melROLL/Opti.Prod/Documentation/Spec and POC !/poc_3.JPG

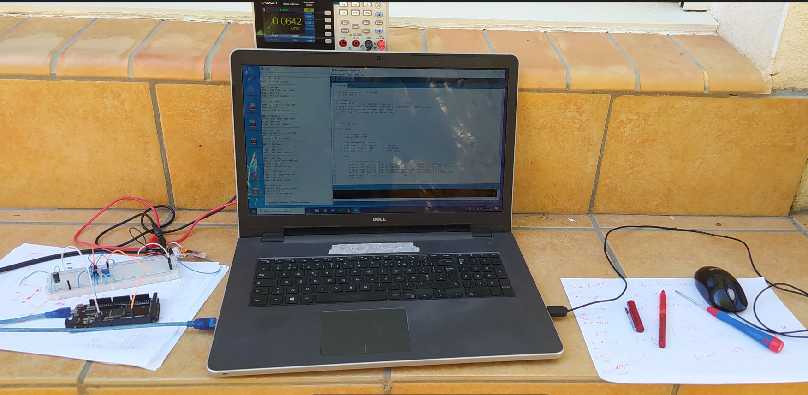
Documentation/Spec and POC !/poc_3.JPG
