melROLL/Opti.Prod/Documentation/Spec and POC !/poc_2.JPG

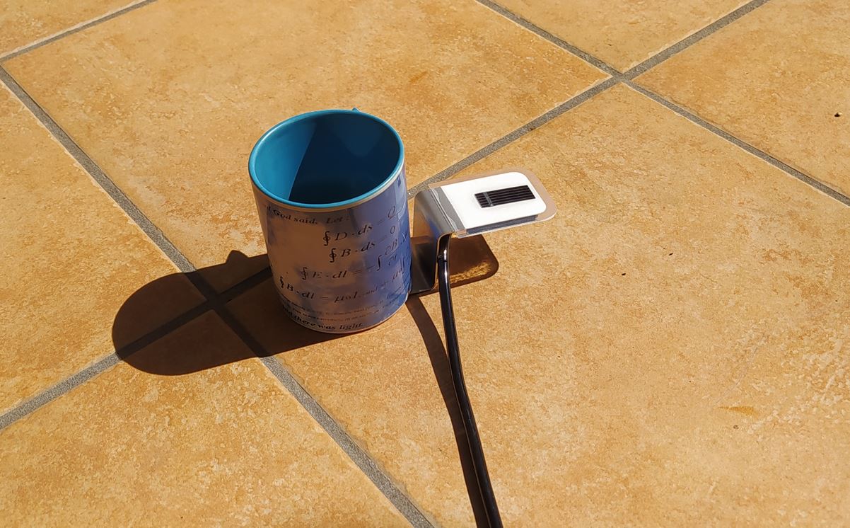
Documentation/Spec and POC !/poc_2.JPG
