melROLL/Opti.Prod/Documentation/Spec and POC !/poc_1.JPG

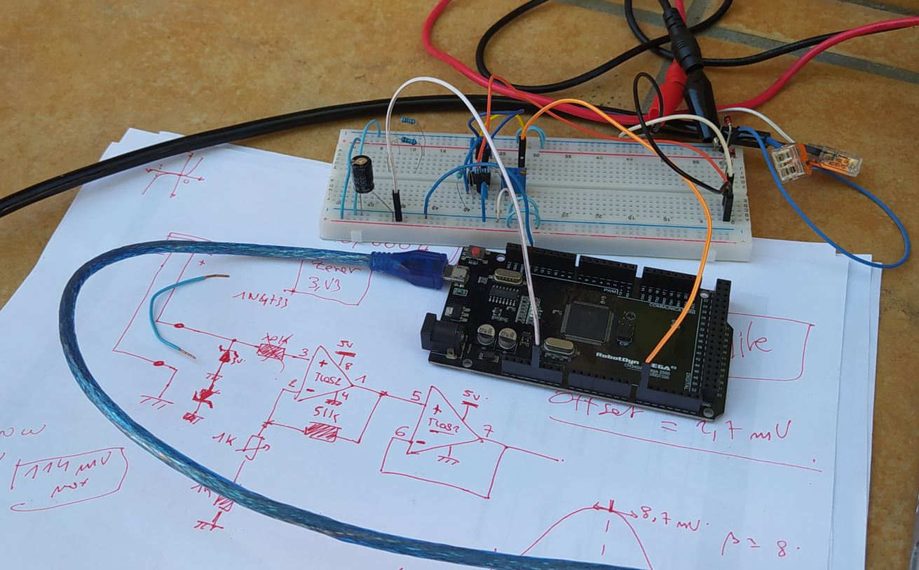
Documentation/Spec and POC !/poc_1.JPG
