melROLL/Opti.Prod/Documentation/Spec and POC !/poc_4.JPG

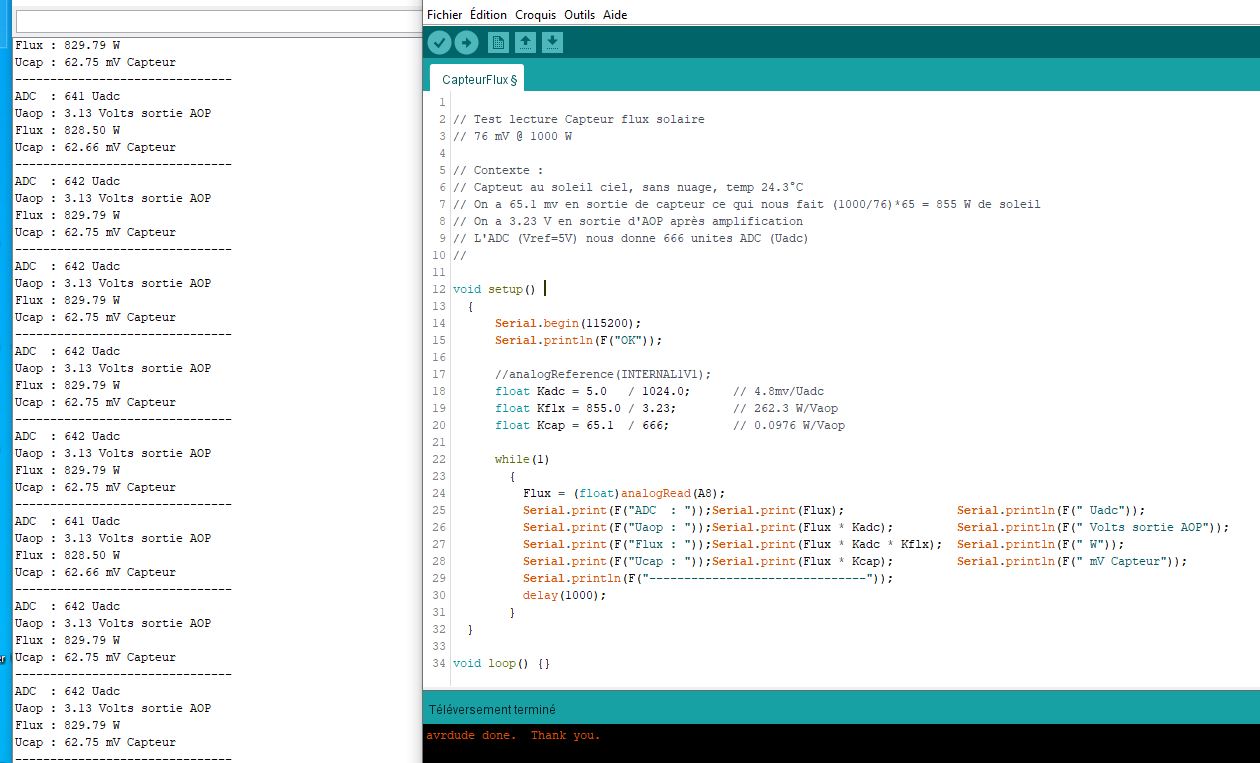
Documentation/Spec and POC !/poc_4.JPG
