melROLL/Opti.Prod/Media/PFP next.jpg

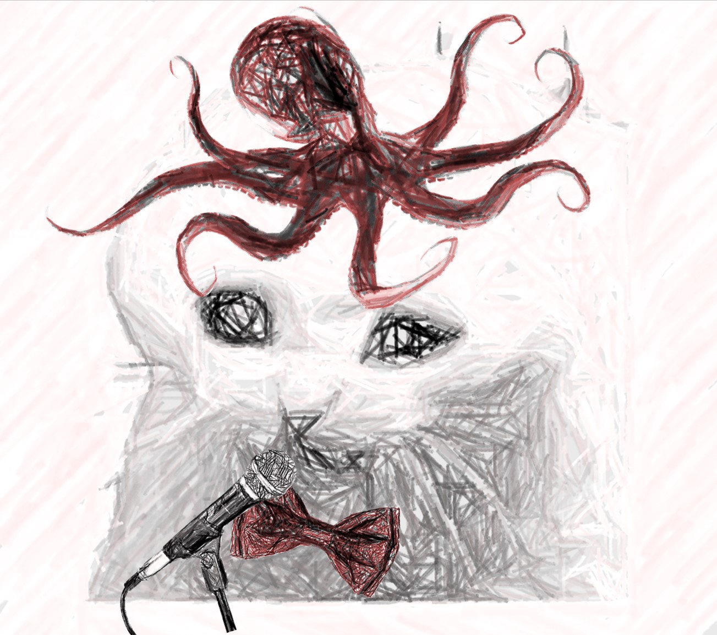
Media/PFP next.jpg
