melROLL/Opti.Prod/Clean_Realease/3DPrintingFile/BoxTop.stl

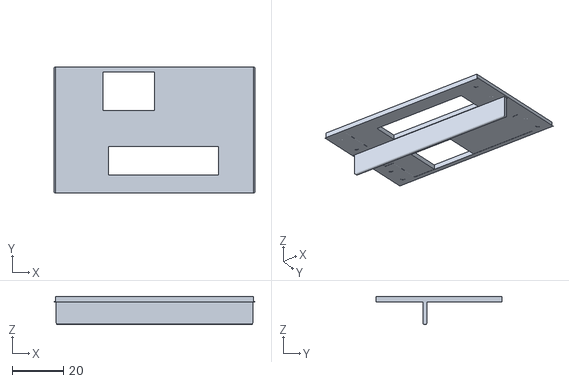
[picture p10: CAD file, 2024-01-13]
Clean_Realease/3DPrintingFile/BoxTop.stl
78.2 x 49.0 x 11.0
