melROLL/Opti.Prod/Clean_Realease/3DPrintingFile/DinRailMount13mm.stl

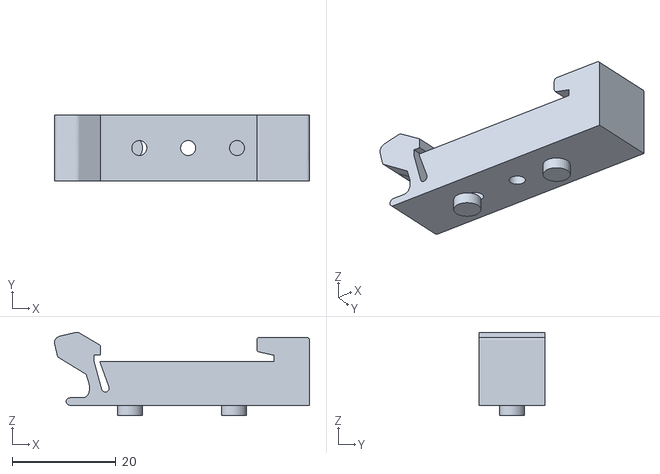
[picture p11: CAD file, 2024-01-12]
Clean_Realease/3DPrintingFile/DinRailMount13mm.stl
49.1 x 12.7 x 16.1
