melROLL/Opti.Prod/Hardware/CadDesign/MountForBox.stl

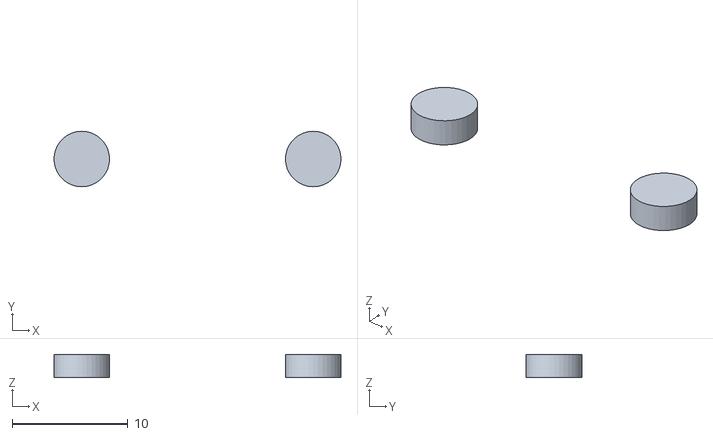
[picture p12: CAD file, 2024-01-12]
Hardware/CadDesign/MountForBox.stl
24.8 x 4.80 x 2.00
