melROLL/Opti.Prod/Hardware/CadDesign/din_rail_mount_G9.STL

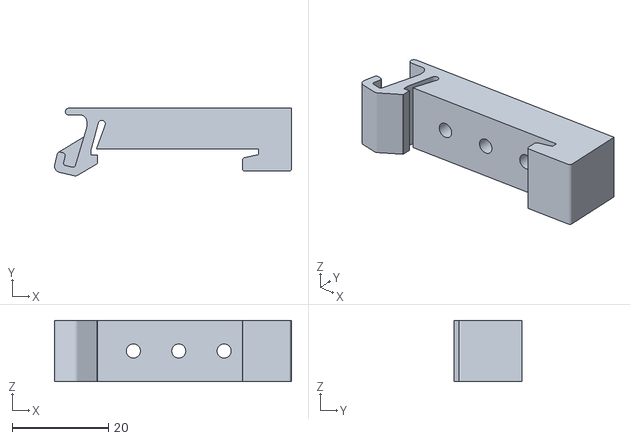
[picture p13: CAD file, 2024-01-12]
Hardware/CadDesign/din_rail_mount_G9.STL
49.1 x 14.1 x 12.7
