melROLL/Opti.Prod/Clean_Realease/3DPrintingFile/DinRailMount30mm.stl

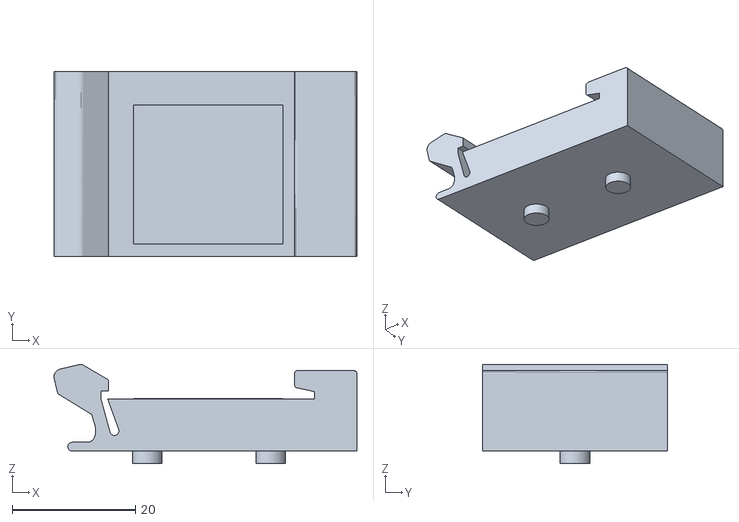
[picture p14: CAD file, 2024-01-12]
Clean_Realease/3DPrintingFile/DinRailMount30mm.stl
49.1 x 30.0 x 16.1
