melROLL/Opti.Prod/Clean_Realease/3DPrintingFile/Box.stl

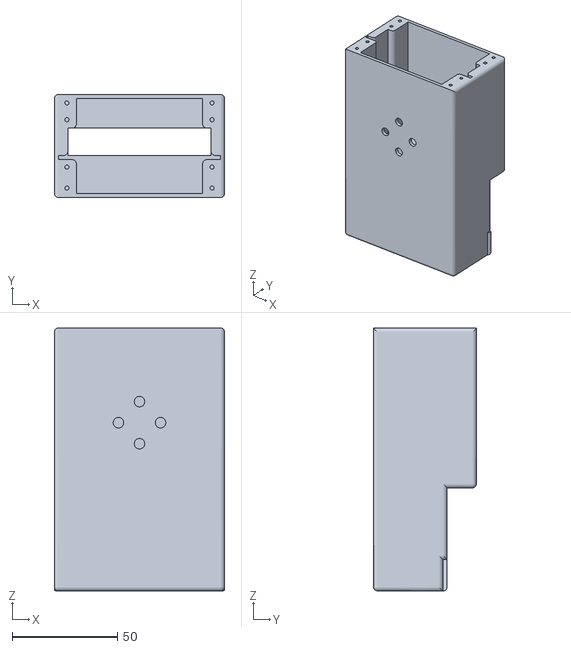
[picture p15: CAD file, 2024-01-11]
Clean_Realease/3DPrintingFile/Box.stl
81.0 x 49.0 x 125.0
