melROLL/Opti.Prod/Hardware/CadDesign/boxmoneymoney.stl

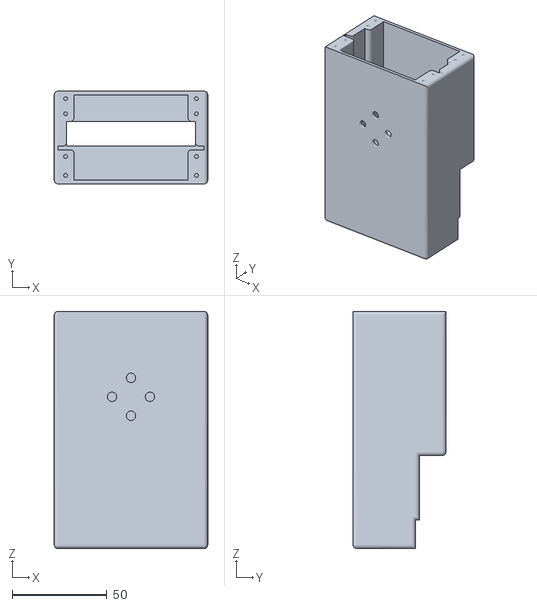
[picture p16: CAD file, 2024-01-10]
Hardware/CadDesign/boxmoneymoney.stl
81.0 x 49.0 x 125.0
