melROLL/Opti.Prod/Hardware/CadDesign/boxmoneymoneyTop.stl

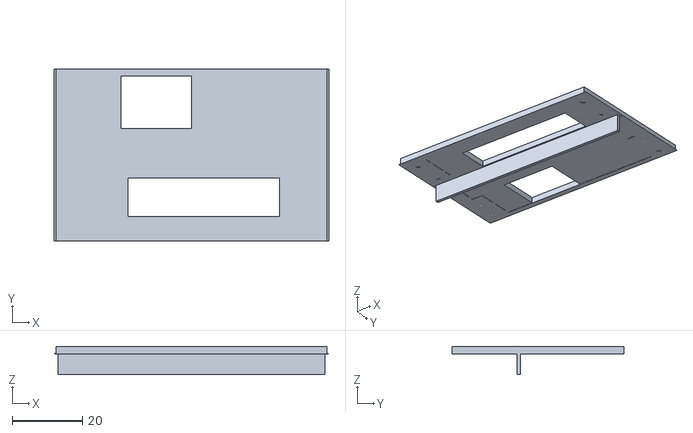
[picture p17: CAD file, 2024-01-11, an earlier design]
Hardware/CadDesign/boxmoneymoneyTop.stl
78.2 x 49.0 x 8.00
