melROLL/Opti.Prod/(list of files, cad)

Other CAD files:
Hardware/CadDesign/DinRail.CATPart
Hardware/CadDesign/boxmoneymoney V2.CATPart
Hardware/CadDesign/boxmoneymoney.CATPart
Hardware/CadDesign/boxmoneymoneyTop.CATPart
