melROLL/Opti.Prod/Documentation/Spec and POC !/WDPV_ Schematic_V2.pdf

@

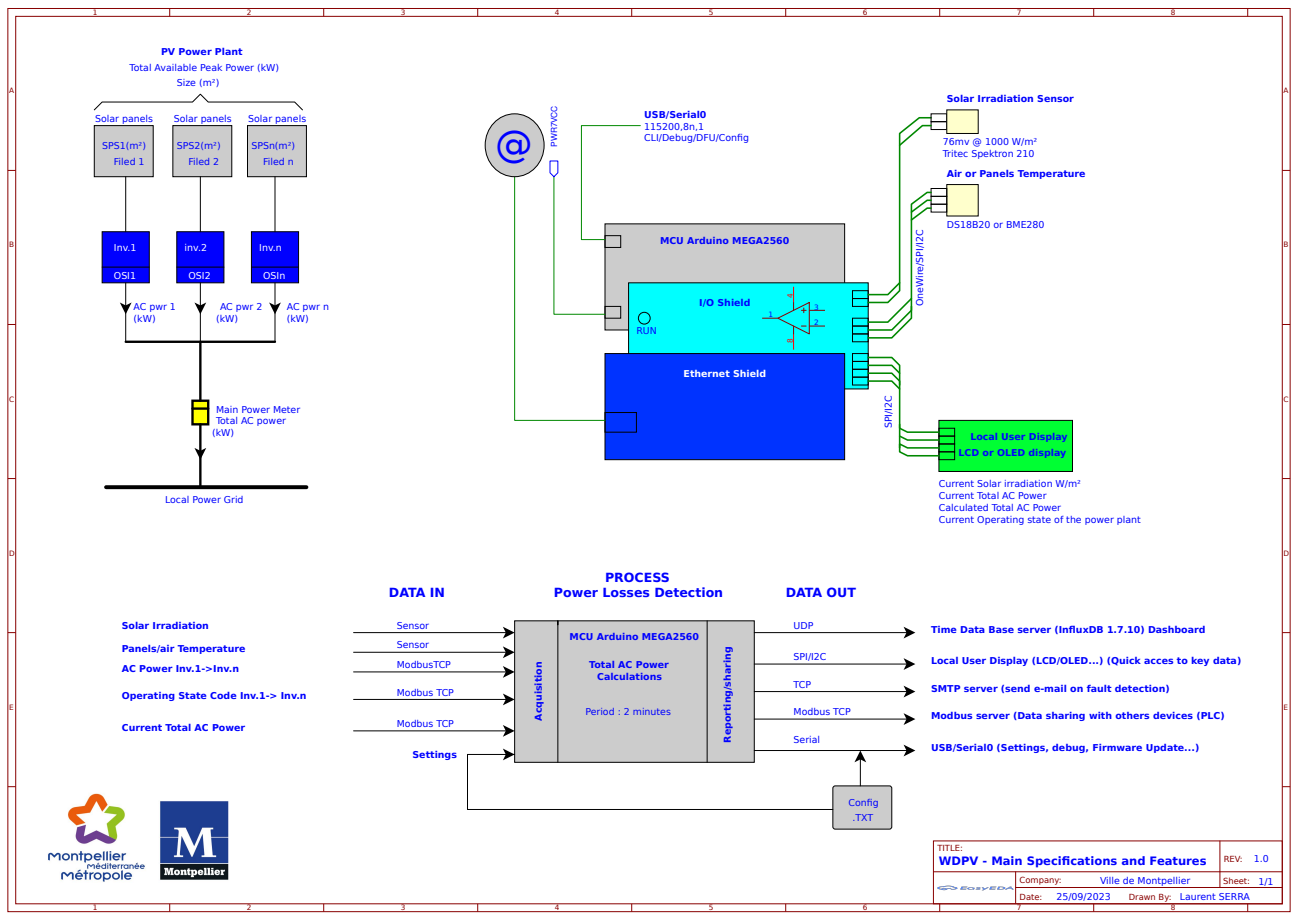
[picture p18: page 1]
TITLE:; WDPV - Main Specifications and Features; REV: 1.0; Date:; Sheet: 1/1; Company:; Ville de Montpellier; MCU Arduino MEGA2560; I/O Shield; Ethernet Shield; PWR7VCC; RUN; Sensor; ModbusTCP; Modbus TCP; UDP; Config; SPI/I2C; TCP; Serial; .TXT; Acquisition; Reporting/sharing; Period : 2 minutes; Inv.1; inv.2; Inv.n; Solar panels; SPS1(m²); SPS2(m²); SPSn(m²); AC pwr 1; OSI1; OSI2; OSIn; Size (m²); Modbus server (Data sharing with others devices (PLC); Settings; DATA IN; DATA OUT; PROCESS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

PV Power Plant
Total Available Peak Power (kW)

Solar Irradiation Sensor

USB/Serial0
CLI/Debug/DFU/Config

Tritec Spektron 210
Air or Panels Temperature

Main Power Meter
Total AC power

Local User Display
LCD or OLED display

Current Solar irradiation W/m²
Current Total AC Power
Calculated Total AC Power
Current Operating state of the power plant

Local Power Grid

Power Losses Detection

Solar Irradiation
Sensor Panels/air Temperature

Time Data Base server (InfluxDB 1.7.10) Dashboard

Local User Display (LCD/OLED...) (Quick acces to key data)

AC Power Inv.1->Inv.n

Total AC Power
Calculations

SMTP server (send e-mail on fault detection)

Operating State Code Inv.1-> Inv.n

Modbus TCP Current Total AC Power

USB/Serial0 (Settings, debug, Firmware Update...)

Drawn By: Laurent SERRA
