melROLL/Opti.Prod/Documentation/WDPV_Schema_V1.pdf

@

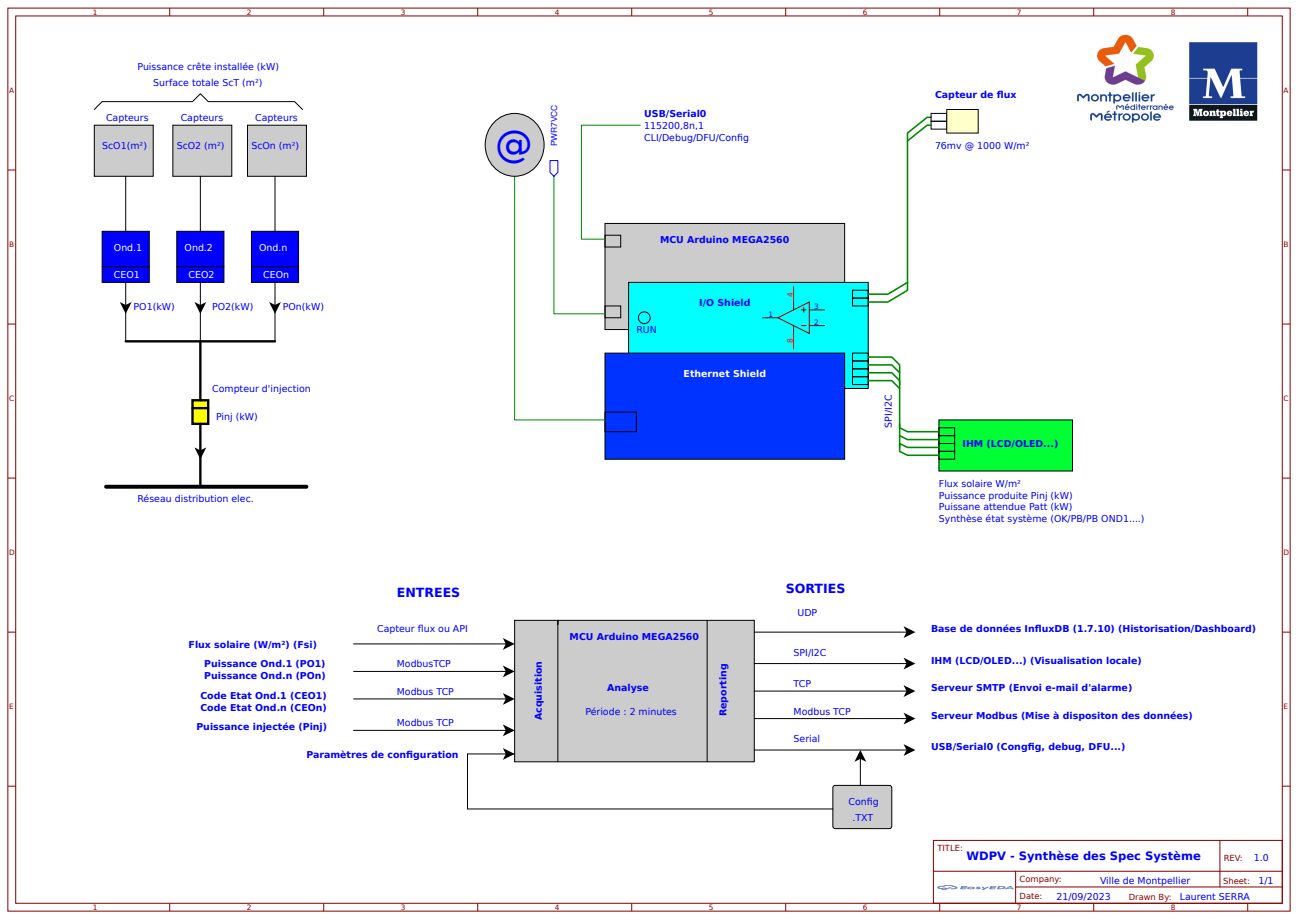
[picture p19: page 1]
TITLE:; WDPV - Synthèse des Spec Système; REV: 1.0; Date:; Sheet: 1/1; Company:; Ville de Montpellier; MCU Arduino MEGA2560; I/O Shield; Ethernet Shield; PWR7VCC; RUN; ModbusTCP; Modbus TCP; UDP; Config; SPI/I2C; TCP; Serial; .TXT; Acquisition; Analyse; Reporting; Période : 2 minutes; Ond.1; Ond.2; Ond.n; Capteurs; ScO1(m²); ScO2 (m²); ScOn (m²); POn(kW); CEO1; CEO2; CEOn; Compteur d'injection; Pinj (kW); Serveur Modbus (Mise à dispositon des données); ENTREES; SORTIES

Puissance crête installée (kW)
Surface totale ScT (m²)

Capteur de flux

USB/Serial0
CLI/Debug/DFU/Config

IHM (LCD/OLED...)

Flux solaire W/m²
Puissance produite Pinj (kW)
Puissane attendue Patt (kW)
Synthèse état système (OK/PB/PB OND1....)

Réseau distribution elec.

Capteur flux ou API

Base de données InfluxDB (1.7.10) (Historisation/Dashboard)

Flux solaire (W/m²) (Fsi)
Puissance Ond.1 (PO1)
Puissance Ond.n (POn)
Code Etat Ond.1 (CEO1)
Code Etat Ond.n (CEOn)
Modbus TCP Puissance injectée (Pinj)

IHM (LCD/OLED...) (Visualisation locale)

Serveur SMTP (Envoi e-mail d'alarme)

USB/Serial0 (Congfig, debug, DFU...)

Paramètres de configuration

Drawn By: Laurent SERRA
