melROLL/Opti.Prod/(list of files, drawings)

Other design files:
Clean_Realease/Kicad_Schem_And_PCB/freerouting.dsn
