melROLL/Opti.Prod/Hardware/Kicad/OptiprodV1/ProjetSemestreKicad.kicad_pcb

## KiCad design Hardware/Kicad/OptiprodV1/ProjetSemestreKicad.kicad_pcb (2023-09-15, an earlier design)

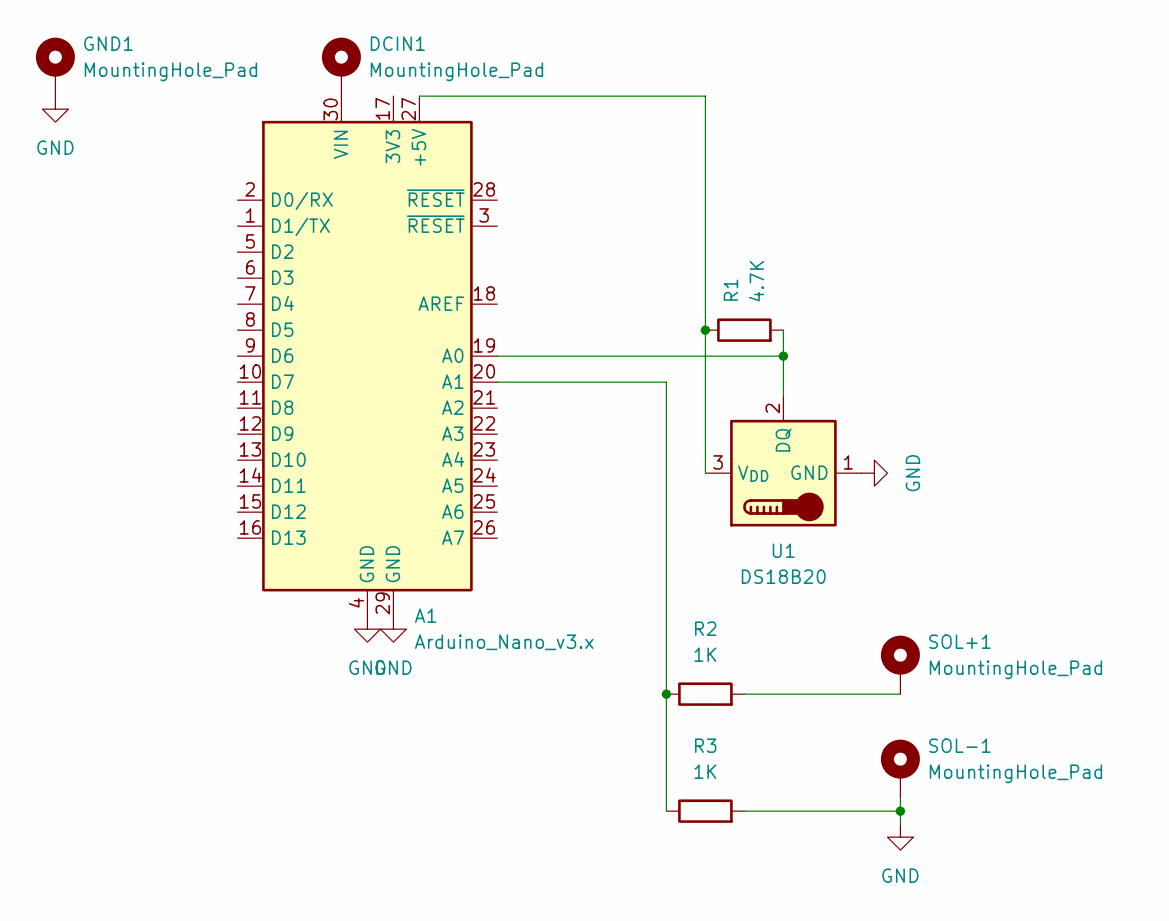
[picture p20: schematic ProjetSemestreKicad.kicad_sch]

Parts:
A1: Arduino_Nano_v3.x; Arduino_Nano
DCIN1: MountingHole_Pad; Pin_D1.0mm_L10.0mm
GND1: MountingHole_Pad; Pin_D1.0mm_L10.0mm
R1: 4.7K; R_Axial_DIN0207_L6.3mm_D2.5mm_P7.62mm_Horizontal
R2, R3: 1K; R_Axial_DIN0207_L6.3mm_D2.5mm_P7.62mm_Horizontal
SOL+1: MountingHole_Pad; Pin_D1.0mm_L10.0mm
SOL-1: MountingHole_Pad; Pin_D1.0mm_L10.0mm
U1: DS18B20; TO-92_Inline

Connections:
GND: A1.4 (GND), A1.29 (GND), GND1.1, R3.2, SOL-1.1, U1.1 (GND)
unnamed: A1.27 (+5V), R1.1, U1.3 (V_{DD})
unnamed: A1.19 (A0), R1.2, U1.2 (DQ)
unnamed: A1.20 (A1), R2.1, R3.1
unnamed: A1.30 (VIN), DCIN1.1
unnamed: R2.2, SOL+1.1

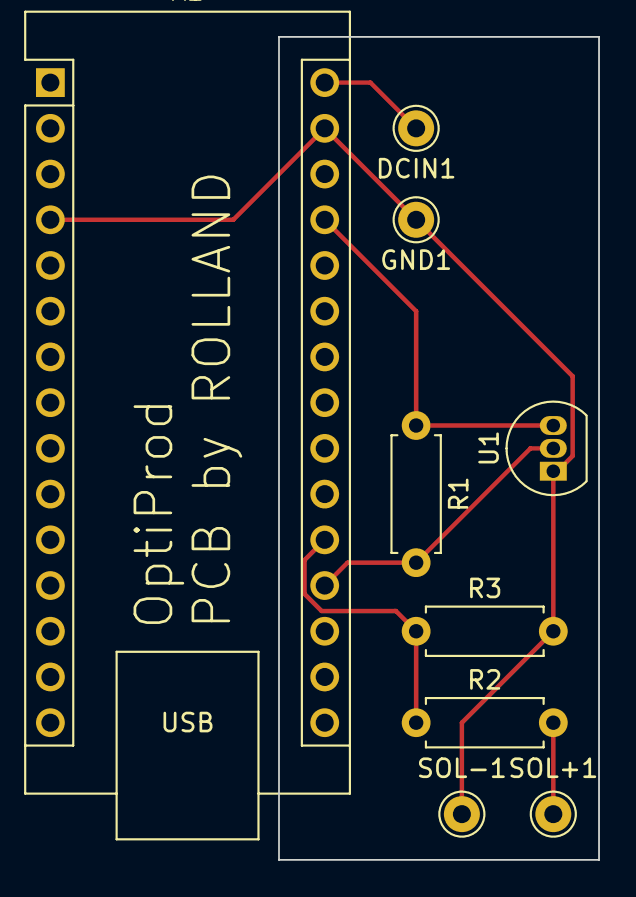
[picture p21: board ProjetSemestreKicad.kicad_pcb from above]

Board: 2 copper layers, 17.8 x 45.7 mm, 9 parts (0 on the bottom side), 6 nets.
