melROLL/Opti.Prod/Hardware/Kicad/OptiprodCommand/OptiprodV2.kicad_pcb

## KiCad design Hardware/Kicad/OptiprodCommand/OptiprodV2.kicad_pcb (2023-12-01)

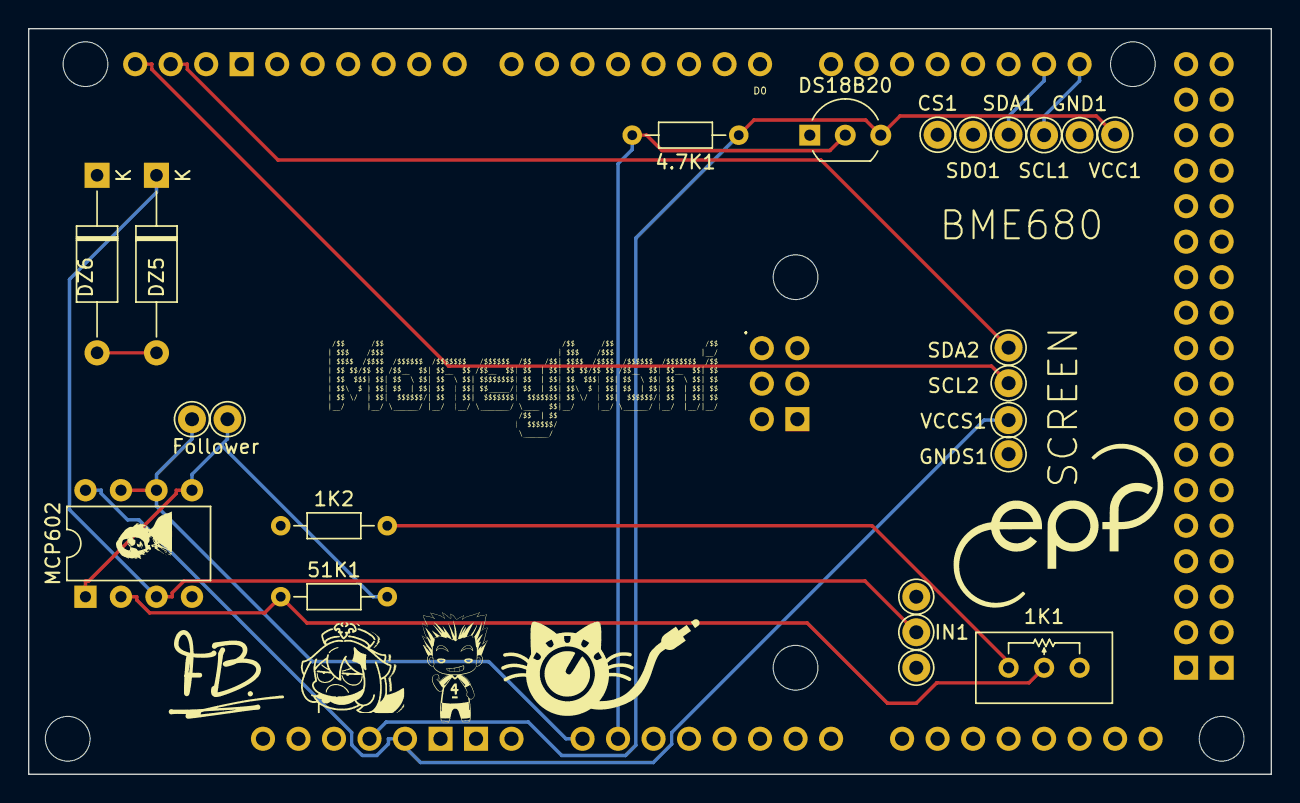
[picture p22: board OptiprodV2.kicad_pcb from above]

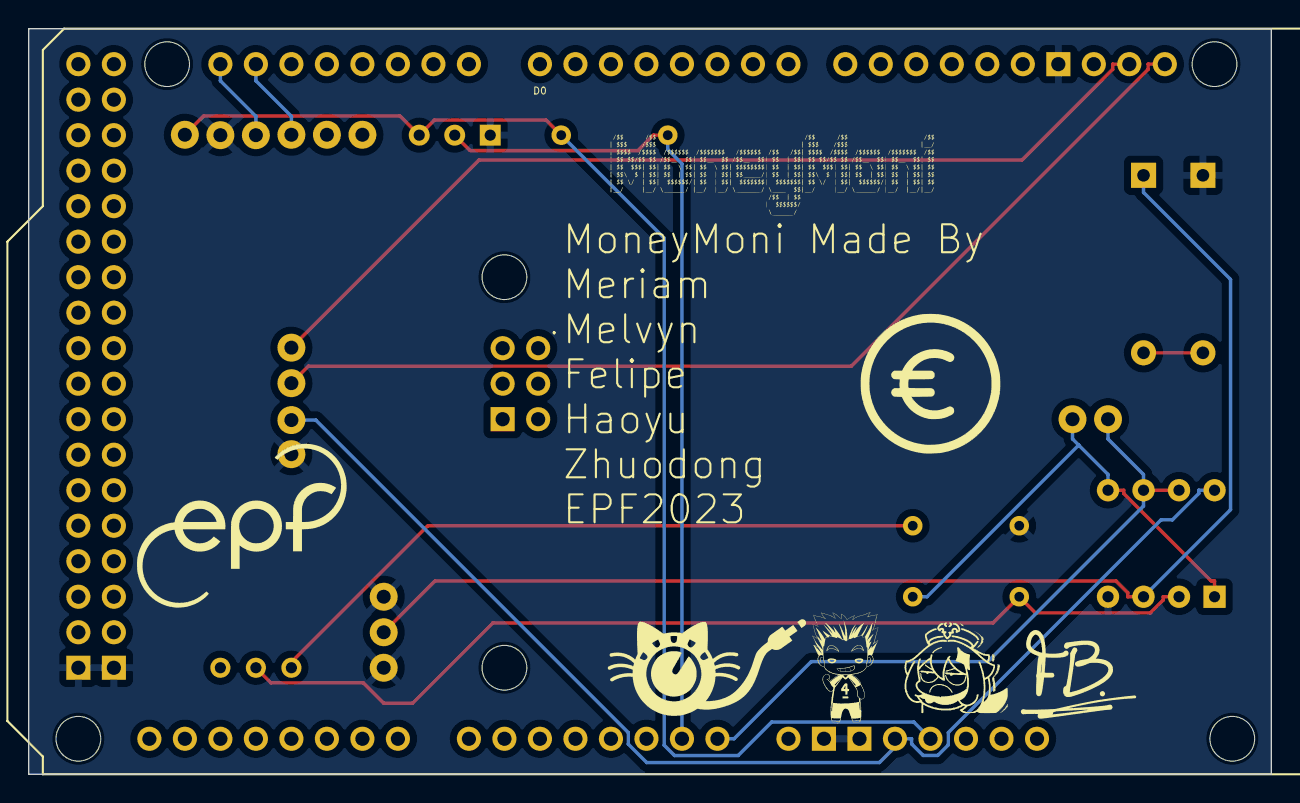
[picture p23: board OptiprodV2.kicad_pcb from below]

Board: 2 copper layers, 88.9 x 53.3 mm, 37 parts (7 on the bottom side), 14 nets.

Parts:
1K1: TrimPot_T73YEt_1k; Potentiometer_Bourns_3296W_Vertical
1K2, 4.7K1, 51K1: R; R_Axial_DIN0204_L3.6mm_D1.6mm_P7.62mm_Horizontal
A2: Arduino_Mega2560_R3_Shield
CS1: MountingHole_Pad; Pin_D1.0mm_L10.0mm
DS18B20: DS18B20; TO-92_Inline_Wide
DZ5, DZ6: 1N4733; D_A-405_P12.70mm_Horizontal
Follower1, Follower2: MountingHole_Pad; Pin_D1.0mm_L10.0mm
G:jgggjfuy: LOGO; ZHK8MM
G:jgggjfuykjfèdtrdètuvf_yvc: LOGO; ZHK8MM
GND1: MountingHole_Pad; Pin_D1.0mm_L10.0mm
GNDIN1, GNDIN2: MountingHole_Pad; Pin_D1.0mm_L10.0mm
GNDS1: MountingHole_Pad; Pin_D1.0mm_L10.0mm
Ghhhgfcccdcdfcfgvfvfvdfcxdrdsqaqhjgugctyv: LOGO; Moneymoney25
Gjchfmljkgjhv: LOGO; Haoyu8MM
I IUG UYGHIUNIJ?CU NC4R3H44IRB: LOGO; FelipeBarbaste10mm
IN1: MountingHole_Pad; Pin_D1.0mm_L10.0mm
KJHHIB9UYG 8TBYFI TG8Y : LOGO; EPFLOGO15MM
MCP602: TL082; DIP-8_W7.62mm
SCL1, SCL2: MountingHole_Pad; Pin_D1.0mm_L10.0mm
SDA1, SDA2: MountingHole_Pad; Pin_D1.0mm_L10.0mm
SDO1: MountingHole_Pad; Pin_D1.0mm_L10.0mm
VCC1: MountingHole_Pad; Pin_D1.0mm_L10.0mm
VCCS1: MountingHole_Pad; Pin_D1.0mm_L10.0mm
azertyuxcvbngfdsqzert: LOGO; EPFLOGO15MM
eopjohkbihvçh,&iàéahihazdnçià?ADZO0IERZGDSQHJ32GN0JCH3 0KCINR39XNGZHENCHZUNVYHIUNHC2NIUN3: LOGO; Moneymoney30
ggfrtdrdpopop: LOGO; Haoyu8MM
hhfttyhgfdssaazzqwxcvbn,kpo: LOGO; eurologo
khojhvgvgvjhbhjvuuuzuaanhhsrrsnnf1456789876432112345678765432123467U8765432123456765432134567UI: LOGO; 15mmlogoRW.kicadnonreverse_mod
pjbiçh u_tftf: LOGO; FelipeBarbaste10mm
uhuhh: LOGO; 15mmlogoRW.kicadnonreverse_mod

Connections:
GND: 1K2.1, A2.GND1 (GND), A2.GND2 (GND), A2.GND3 (GND), A2.GND5 (GND), A2.GND6 (GND), DS18B20.1 (GND), DZ6.1 (K), GND1.1, GNDIN1.1, GNDIN2.1, GNDS1.1, MCP602.4 (V-)
unnamed: 1K1.2 (Center), 51K1.1, MCP602.2 (-)
unnamed: 1K1.3 (Right), 1K2.2
unnamed: A2.D20 (D20/SDA), SDA1.1
unnamed: A2.D21 (D21/SCL), SCL1.1
unnamed: A2.SCL, SCL2.1
unnamed: A2.SDA, SDA2.1
unnamed: 4.7K1.2, A2.A1, DS18B20.2 (DQ)
unnamed: DZ5.2 (A), DZ6.2 (A)
unnamed: DZ5.1 (K), IN1.1, MCP602.3 (+)
unnamed: 51K1.2, Follower2.1, MCP602.1, MCP602.5 (+)
unnamed: A2.A0, Follower1.1, MCP602.6 (-), MCP602.7
VCC: 4.7K1.1, A2.3V3 (3.3V), DS18B20.3 (V_{DD}), VCC1.1
VCCQ: A2.5V1 (5V), MCP602.8 (V+), VCCS1.1
