melROLL/Opti.Prod/(commit log)

2023-09-14 first commitement
    [ProjetSemestreKicad.kicad_pcb, ProjetSemestreKicad.kicad_sch]
2023-10-12 add temp sensor code combined with modbus
2023-10-27 add flux sensor code
2023-10-27 add the working code of the screen,flux sensor,temp sensor and with modbus connection
2023-11-24 add second temp sensor
2023-12-01 commiting to the project
    [OptiprodV2.kicad_pcb]
2024-01-12 rail mount added
    [DinRail.CATPart, DinRail.stl, DinRailMount13mm.stl, DinRailMount30mm.stl, din_rail_mount_G9.STL]
2024-01-15 Cad Changed
    [boxmoneymoney V2.CATPart]
2024-01-15 final arduino code
